tristynferreiro/perchscale/Housing/Controller_housing/Push_Button/Tach button.png

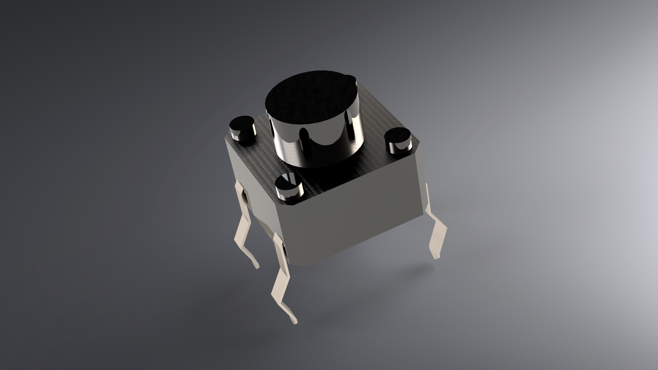
Housing/Controller_housing/Push_Button/Tach button.png
