tristynferreiro/perchscale/README.md

# The Hornbill Sensor Project
Project still in progress
