tristynferreiro/perchscale/Housing/Controller_housing/DM_OLED/1.inch OLED Display Overview.jpg

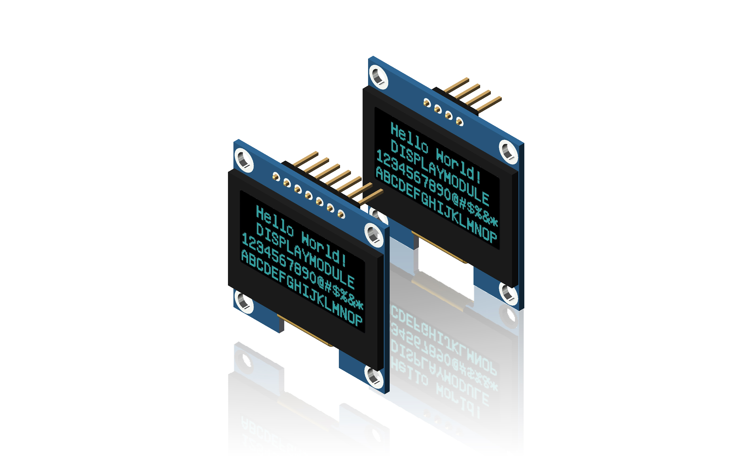
Housing/Controller_housing/DM_OLED/1.inch OLED Display Overview.jpg
