tristynferreiro/perchscale/Housing/Controller_housing/DM_OLED/AZ-Delivery.OLED13.IIC.Blue.jpg

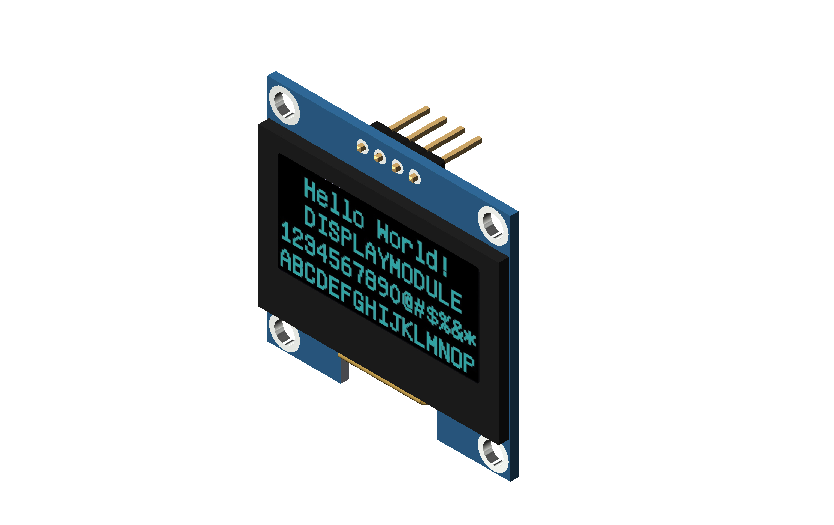
Housing/Controller_housing/DM_OLED/AZ-Delivery.OLED13.IIC.Blue.jpg
