tristynferreiro/perchscale/Housing/Controller_housing/Keystone_1042_Battery_Holder/keystone-PN1042 mechanical.JPG

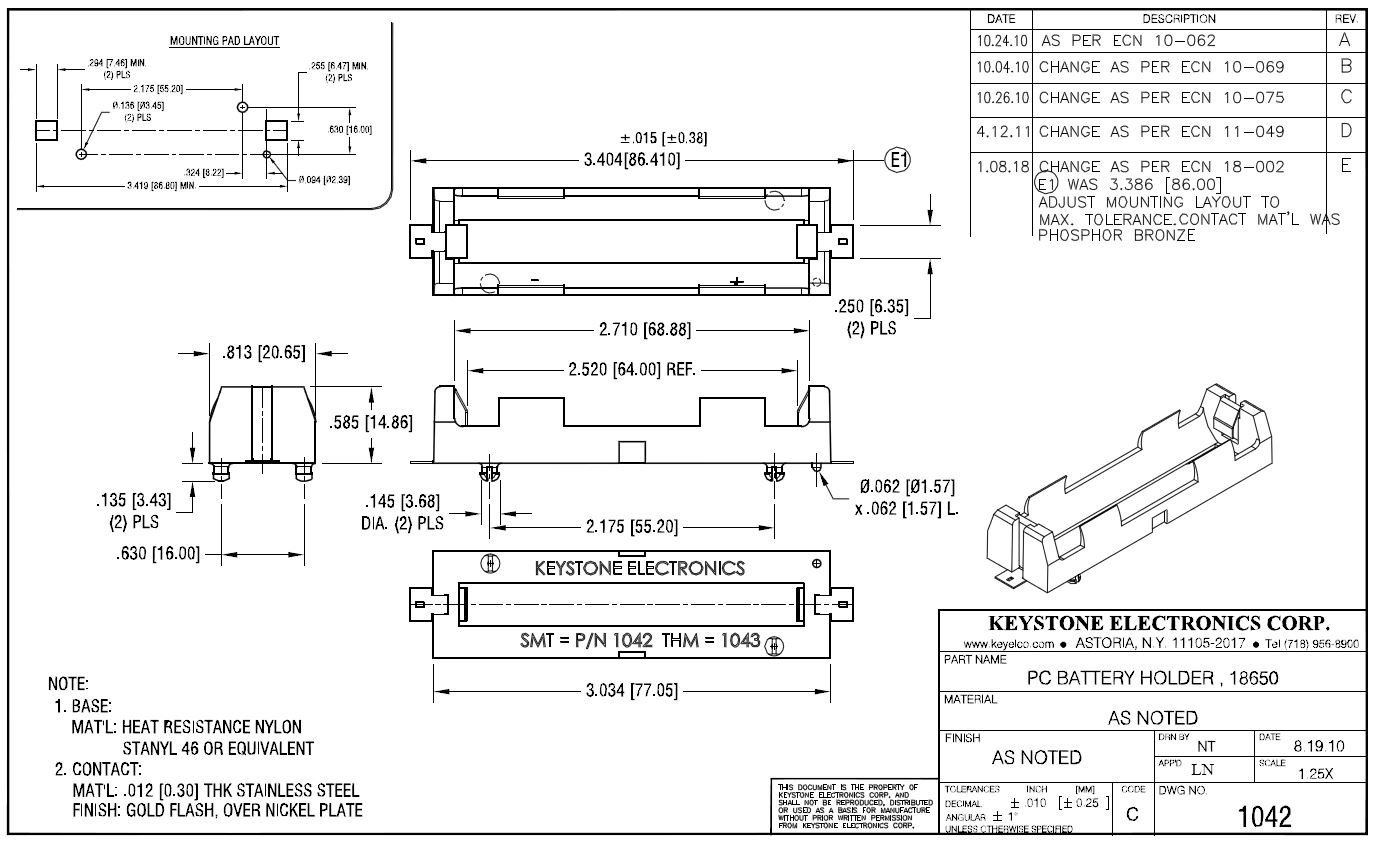
Housing/Controller_housing/Keystone_1042_Battery_Holder/keystone-PN1042 mechanical.JPG
