tristynferreiro/perchscale/Housing/Controller_housing/Keystone_1042_Battery_Holder/Keystone-PN1042 specification.JPG

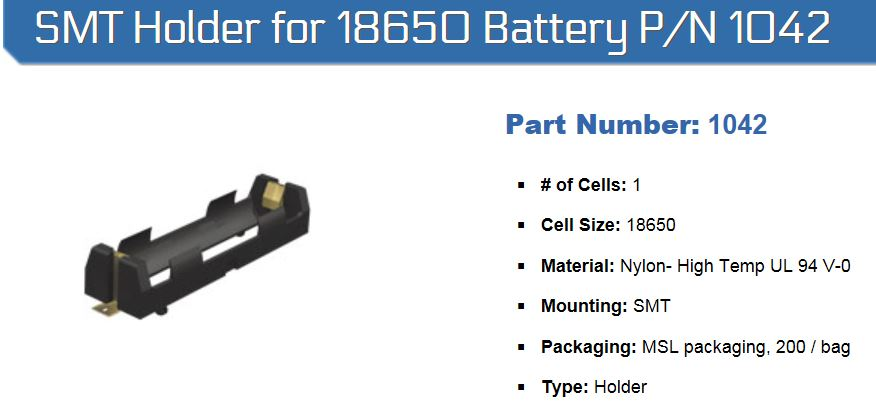
Housing/Controller_housing/Keystone_1042_Battery_Holder/Keystone-PN1042 specification.JPG
