tristynferreiro/perchscale/Housing/Controller_housing/DM_OLED/AZ-Delivery - OLED13 IIC.stp

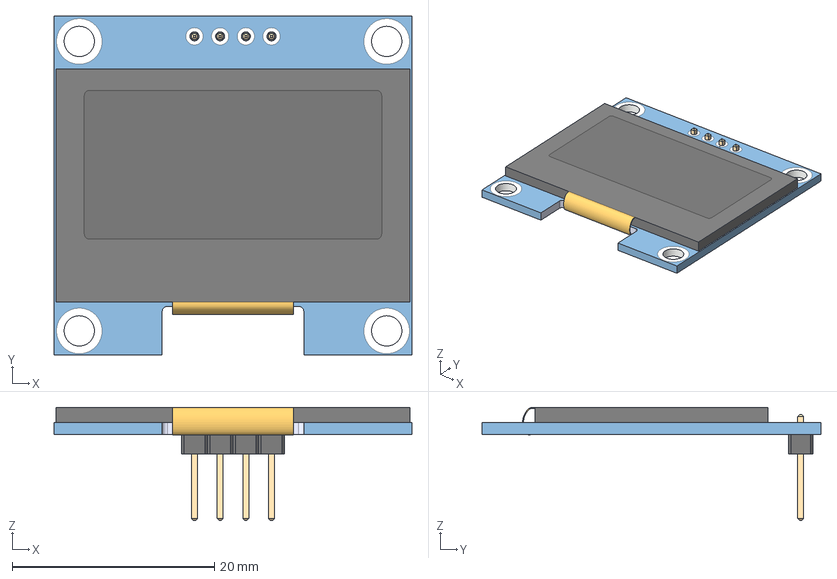
[picture p8: CAD file, 2024-08-07]
Housing/Controller_housing/DM_OLED/AZ-Delivery - OLED13 IIC.stp
35.4 x 33.5 x 11.2 mm
