tristynferreiro/perchscale/Housing/Controller_housing/Keystone_1042_Battery_Holder/keystone-PN1042.STEP

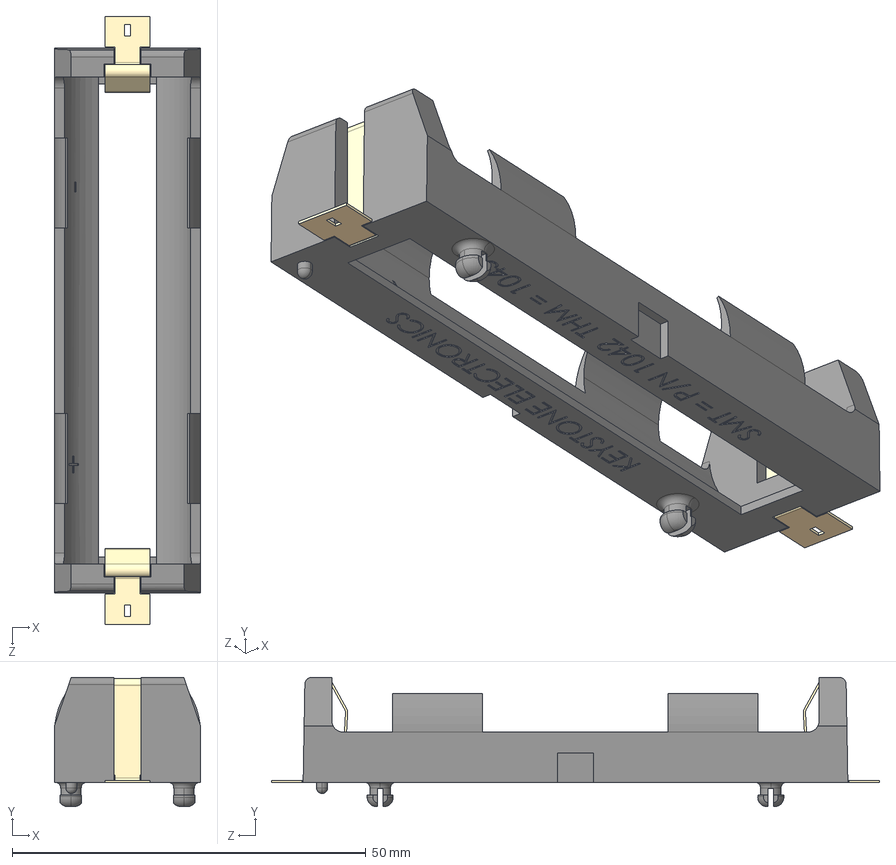
[picture p9: CAD file, 2024-08-07]
Housing/Controller_housing/Keystone_1042_Battery_Holder/keystone-PN1042.STEP
20.7 x 18.3 x 86.0 mm
