tristynferreiro/perchscale/Housing/Controller_housing/Push_Button/6x6 5mm Tach Buton (4 arm).STEP

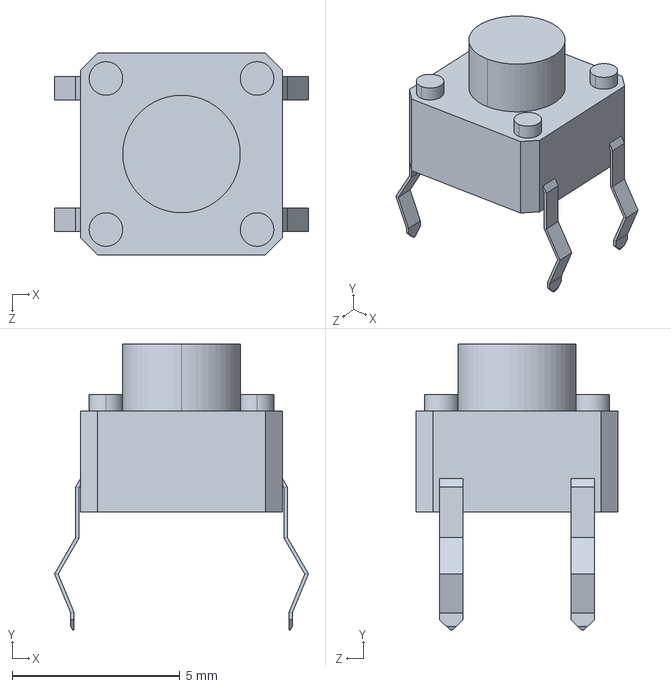
[picture p10: CAD file, 2024-08-07]
Housing/Controller_housing/Push_Button/6x6 5mm Tach Buton (4 arm).STEP
7.57 x 8.52 x 6.01 mm
