tristynferreiro/perchscale/Housing/perchdesign/perchdesign_tbar_v3.step

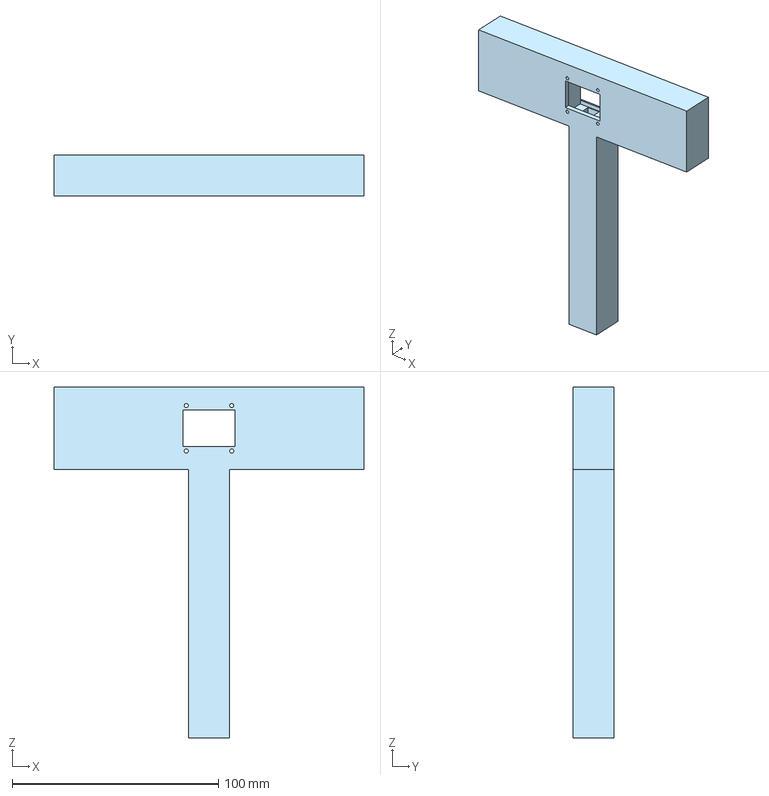
[picture p11: CAD file, 2024-06-24]
Housing/perchdesign/perchdesign_tbar_v3.step
150.0 x 20.0 x 170.0 mm
