tristynferreiro/perchscale/PCB/PS_motherboard/Additional Libraries/74LVC125APW_118/74LVC125APW_118.step

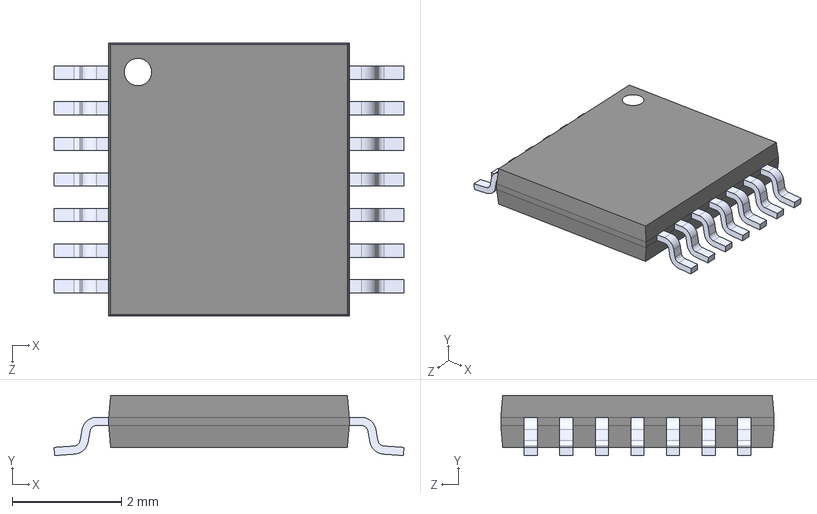
[picture p12: CAD file, 2024-03-22]
PCB/PS_motherboard/Additional Libraries/74LVC125APW_118/74LVC125APW_118.step
6.40 x 1.10 x 5.00 mm
