tristynferreiro/perchscale/PCB/PS_motherboard/Additional Libraries/ADC108S022CIMTX_NOPB/ADC108S022CIMTX_NOPB.step

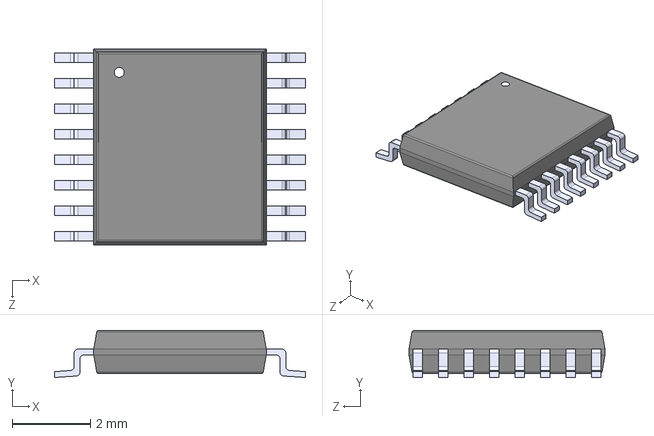
[picture p13: CAD file, 2024-03-22]
PCB/PS_motherboard/Additional Libraries/ADC108S022CIMTX_NOPB/ADC108S022CIMTX_NOPB.step
6.40 x 1.20 x 5.00 mm
