tristynferreiro/perchscale/PCB/PS_motherboard/Additional Libraries/TMP235A2DCKR/TMP235A2DCKR.step

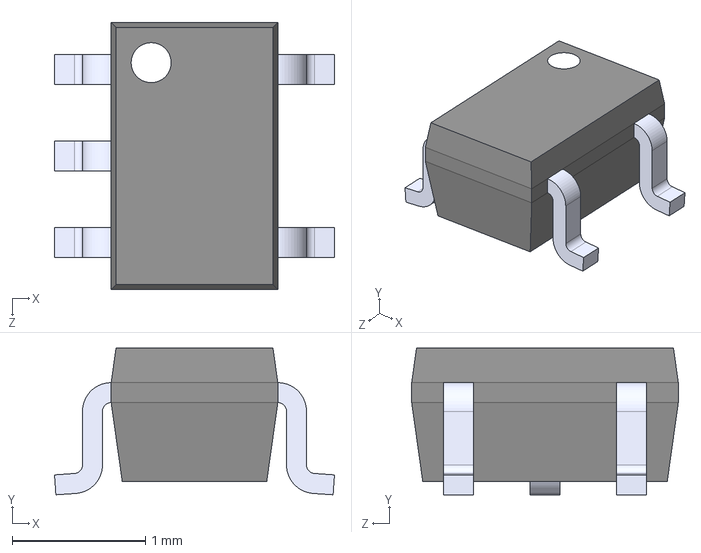
[picture p14: CAD file, 2024-03-22]
PCB/PS_motherboard/Additional Libraries/TMP235A2DCKR/TMP235A2DCKR.step
2.10 x 1.10 x 2.00 mm
