tristynferreiro/perchscale/Housing/Perch Box V7.stl

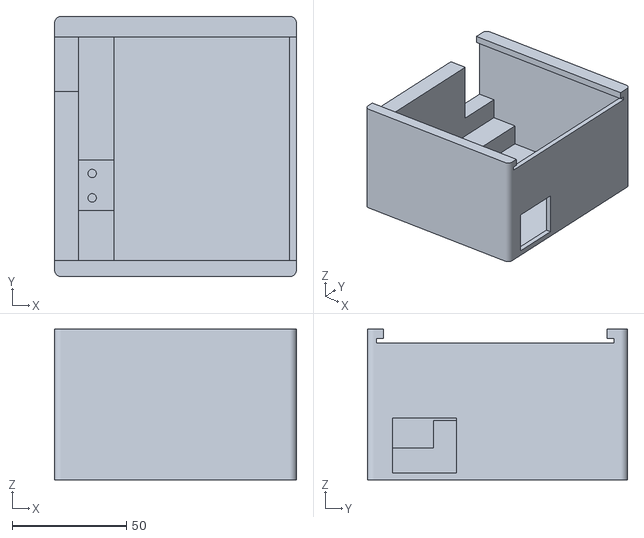
[picture p15: CAD file, 2024-02-02]
Housing/Perch Box V7.stl
106.0 x 114.0 x 66.0
