tristynferreiro/perchscale/Housing/perchdesign/perchdesign_nbarhousinglid_v1.step

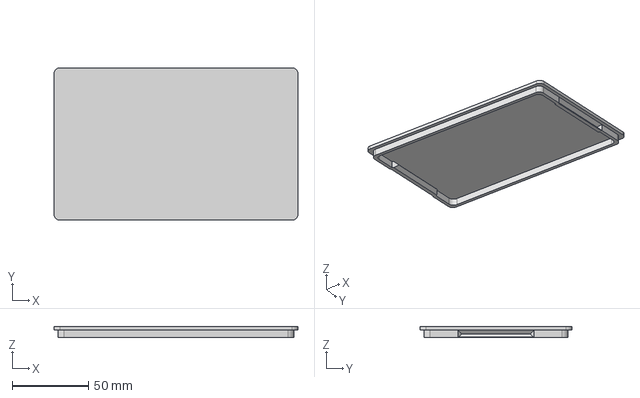
[picture p16: CAD file, 2024-06-24]
Housing/perchdesign/perchdesign_nbarhousinglid_v1.step
160.0 x 100.0 x 7.50 mm
