tristynferreiro/perchscale/Housing/perchdesign/perchdesign_tbarslider_v1.step

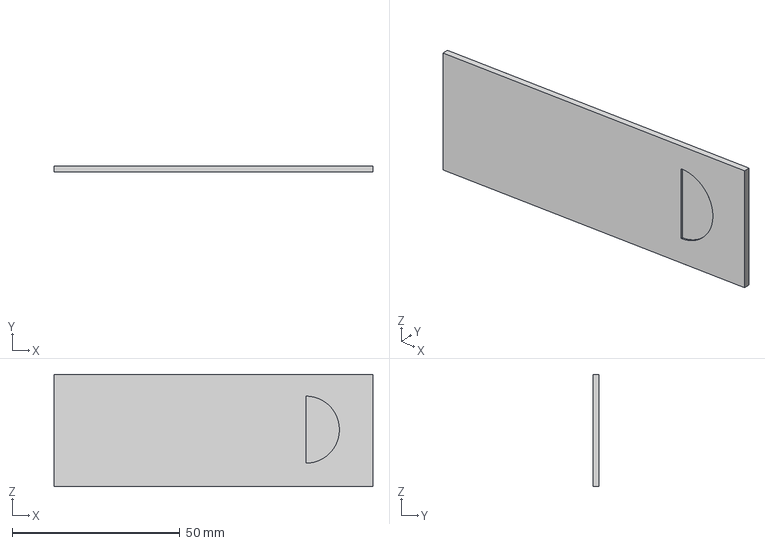
[picture p17: CAD file, 2024-06-24]
Housing/perchdesign/perchdesign_tbarslider_v1.step
95.0 x 1.75 x 33.5 mm
