tristynferreiro/perchscale/Housing/perchdesign/perchdesign_nbarhousingbox_v1.step

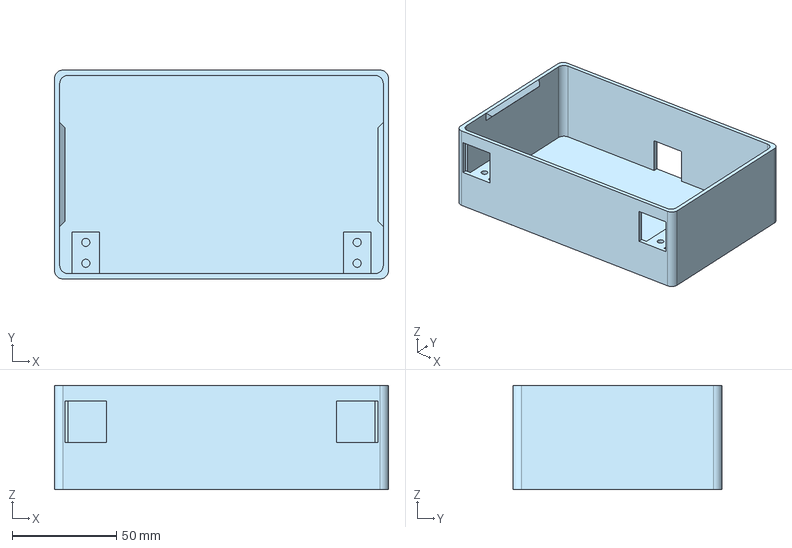
[picture p18: CAD file, 2024-06-24]
Housing/perchdesign/perchdesign_nbarhousingbox_v1.step
160.0 x 100.0 x 50.0 mm
