tristynferreiro/perchscale/Housing/perchdesign/perchdesign_tbarhousinglid_v3.step

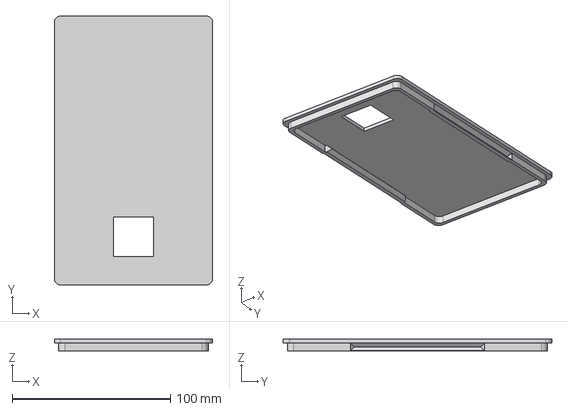
[picture p19: CAD file, 2024-06-24]
Housing/perchdesign/perchdesign_tbarhousinglid_v3.step
100.0 x 170.0 x 7.50 mm
