tristynferreiro/perchscale/Housing/perchdesign/perchdesign_tbarhousingbox_v3.step

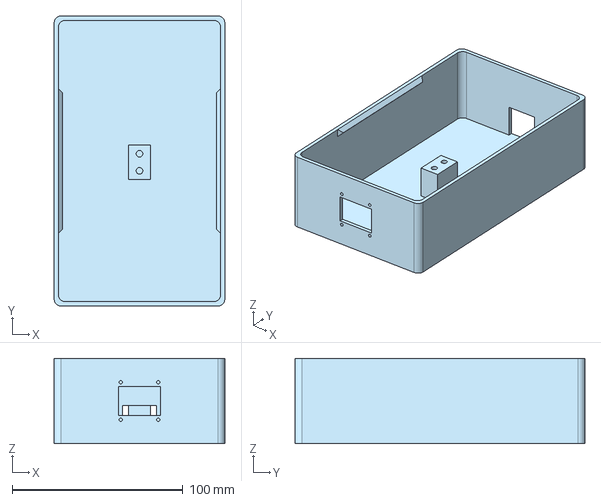
[picture p20: CAD file, 2024-06-24]
Housing/perchdesign/perchdesign_tbarhousingbox_v3.step
100.0 x 170.0 x 50.0 mm
