tristynferreiro/perchscale/Housing/perchdesign/housing - Box.stl

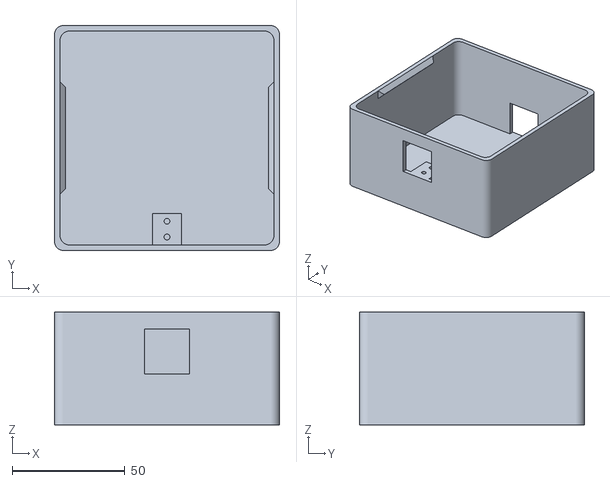
[picture p21: CAD file, 2024-04-19]
Housing/perchdesign/housing - Box.stl
100.0 x 100.0 x 50.0
