tristynferreiro/perchscale/Housing/Scale Base.stl

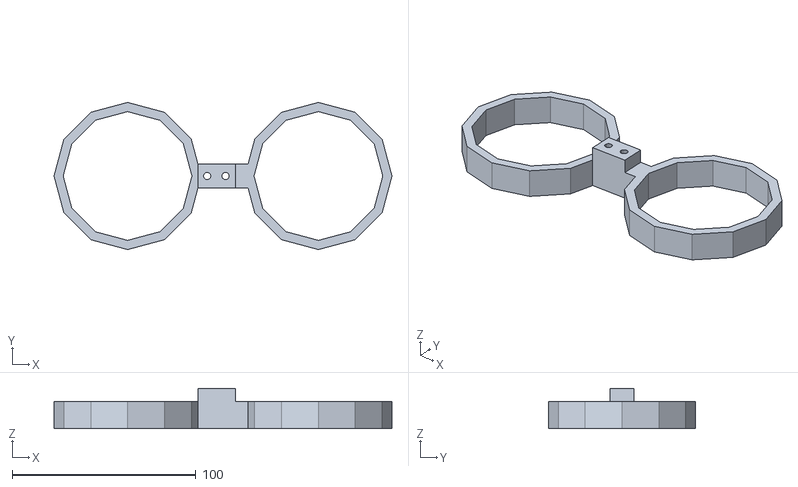
[picture p22: CAD file, 2023-05-17]
Housing/Scale Base.stl
183.8 x 80.0 x 22.0
