tristynferreiro/perchscale/Housing/Perch.stl

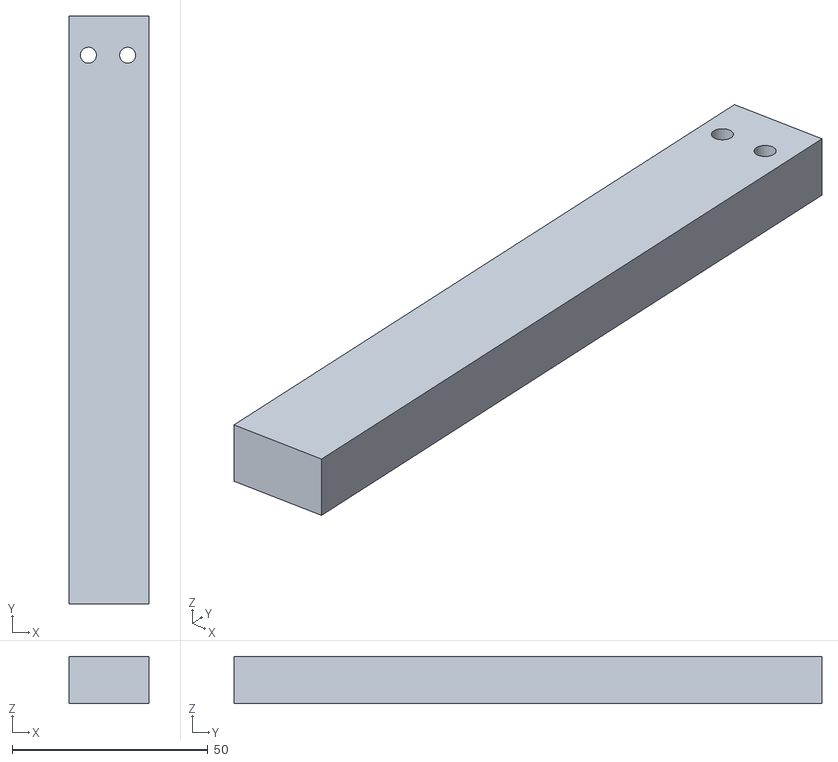
[picture p23: CAD file, 2023-05-17]
Housing/Perch.stl
20.5 x 150.0 x 12.0
