tristynferreiro/perchscale/Housing/perchdesign/perchdesign_nbar_v1.step

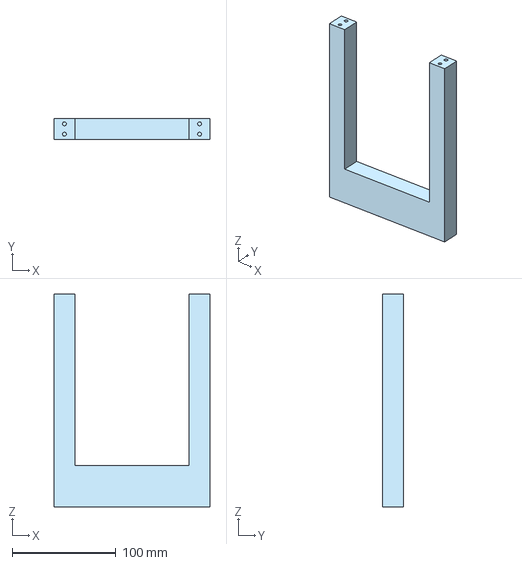
[picture p24: CAD file, 2024-04-19]
Housing/perchdesign/perchdesign_nbar_v1.step
150.0 x 20.0 x 205.0 mm
