tristynferreiro/perchscale/Housing/perchdesign/perchdesign_nbar_v1_10cm_height.step

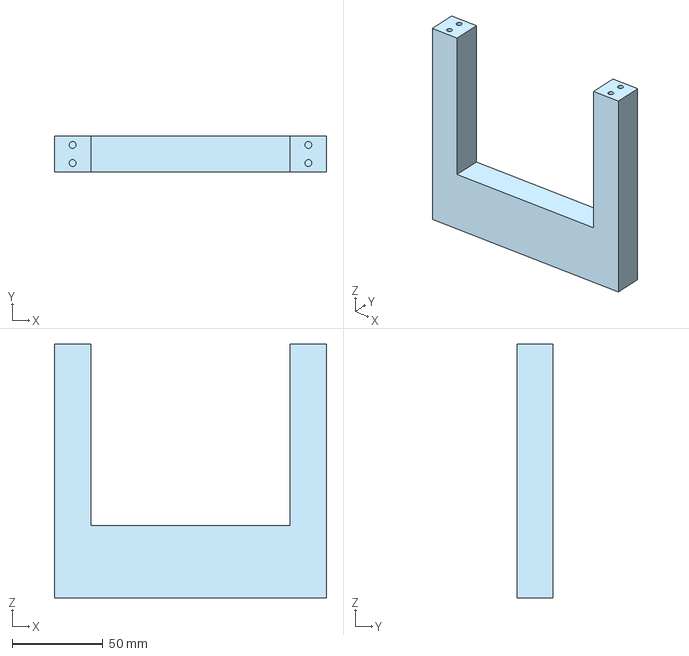
[picture p25: CAD file, 2024-04-19]
Housing/perchdesign/perchdesign_nbar_v1_10cm_height.step
150.0 x 20.0 x 140.0 mm
