tristynferreiro/perchscale/Housing/perchdesign/perchdesign_tbar_v1.stl

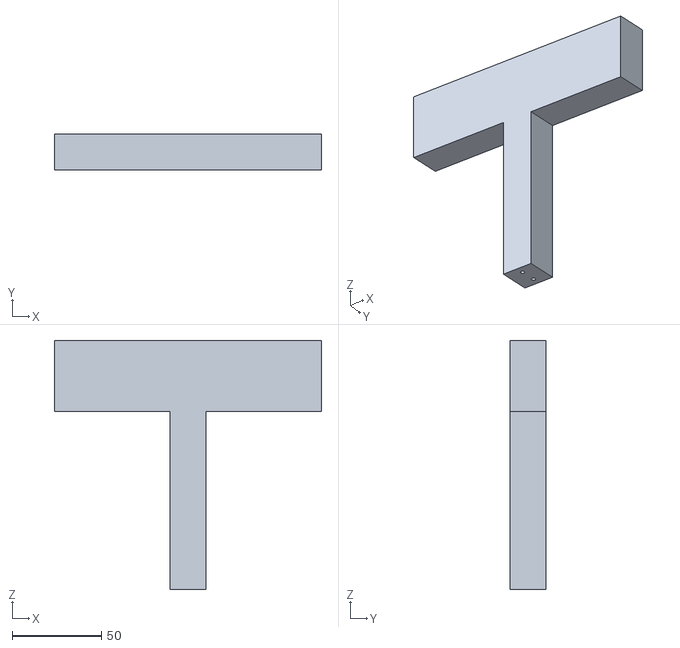
[picture p26: CAD file, 2024-04-12]
Housing/perchdesign/perchdesign_tbar_v1.stl
150.0 x 20.0 x 140.0
