tristynferreiro/perchscale/(list of files, cad)

Other CAD files:
Housing/Controller_housing/Push_Button/6x6 5mm Tach Buton (4 arm).SLDPRT
Housing/Perch Box V1.stl
Housing/Perch Box V2.stl
Housing/Perch Box V3.stl
Housing/Perch Box V4.stl
Housing/Perch Box V5.stl
Housing/Perch Box V6.stl
Housing/perchdesign/perchdesign_tbar_v2.step
Housing/perchdesign/perchdesign_tbarhousingbox_v1.step
Housing/perchdesign/perchdesign_tbarhousinglid_v1.step
Housing/testprints_screw_sizing.step
