tristynferreiro/perchscale/EEE4113F/Kalman_Filter/test_scale.txt

303.99
303.98
303.97
303.95
303.94
303.93
303.93
303.92
303.91
303.90
303.88
303.88
303.87
303.86
303.85
303.84
303.83
303.83
303.84
303.84
303.84
303.84
303.85
303.85
303.85
303.85
303.84
303.85
303.85
303.85
303.85
303.86
303.86
303.87
303.87
303.87
303.87
303.87
303.87
303.87
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

done

91.30
110.28
129.21
146.89
160.96
171.62
181.11
190.68
201.82
216.06
230.47
243.01
251.28
255.12
252.91
248.94
246.73
244.43
236.45
227.18
220.06
217.34
220.90
229.08
238.30
246.62
253.05
255.29
253.83
249.57
244.50
244.21
249.96
256.27
255.92
250.22
248.32
249.97
253.42
256.85
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

done

86.57
105.56
124.53
143.51
162.50
181.48
200.46
219.45
238.39
255.89
271.42
285.92
296.56
301.77
303.59
303.91
303.92
303.63
303.63
303.62
303.62
303.61
303.60
303.59
303.58
303.57
303.57
303.56
303.56
303.56
303.55
303.55
303.55
303.55
303.55
303.55
303.54
303.54
303.55
303.55
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

82.46
101.38
120.36
139.34
158.34
177.46
196.47
215.45
234.43
252.87
270.40
287.09
298.49
304.03
306.00
306.08
305.84
306.73
308.43
314.22
316.70
316.81
316.82
316.71
316.78
317.41
317.95
318.00
318.00
317.36
316.02
315.37
315.06
315.05
314.87
313.23
307.60
305.15
304.58
304.92
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

done

85.11
104.07
123.04
142.02
160.99
179.96
198.93
217.89
236.86
255.61
272.58
287.06
295.55
300.12
302.62
302.62
302.24
301.81
301.86
301.89
301.91
301.94
302.18
301.83
301.21
301.23
301.27
301.09
299.87
298.71
298.98
299.23
299.38
300.30
301.41
301.90
302.10
302.34
302.01
301.98
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

done

90.07
109.20
128.27
147.27
166.26
185.24
204.24
223.23
242.22
261.08
278.36
293.18
301.80
304.23
304.32
304.32
304.21
304.07
304.00
303.91
303.91
303.90
303.90
303.90
303.90
304.01
305.15
305.62
305.61
305.59
305.59
305.58
305.41
304.58
301.29
299.64
298.93
297.49
295.71
295.39
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

done

85.20
104.22
123.24
142.26
161.27
180.30
199.32
218.58
237.83
256.61
274.26
288.81
299.94
304.49
304.76
304.83
304.37
303.40
303.11
303.12
303.12
303.12
303.12
303.11
303.13
303.13
303.26
303.54
303.50
302.90
301.58
300.80
300.76
300.92
301.69
303.02
303.29
303.46
303.68
303.40
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

84.55
103.54
122.51
141.50
160.48
179.47
198.46
217.44
236.42
255.38
272.91
287.32
298.13
302.45
303.85
304.07
304.07
304.07
304.06
304.05
304.04
304.04
304.03
304.02
304.02
304.01
304.00
304.00
303.99
303.99
303.98
303.98
303.97
303.97
303.97
303.97
303.97
303.97
303.97
303.97
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

done

81.34
98.76
116.74
135.07
153.90
172.88
191.89
210.62
228.48
245.57
260.98
273.62
282.83
289.25
294.17
297.90
300.59
302.19
303.21
303.90
304.07
304.22
304.25
304.25
304.25
304.31
304.32
304.32
304.33
304.33
304.34
304.34
304.34
304.34
304.35
304.35
304.36
304.37
304.38
304.39
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

done
