tristynferreiro/perchscale/EEE4113F/Kalman_Filter/Kalman Filters.pdf

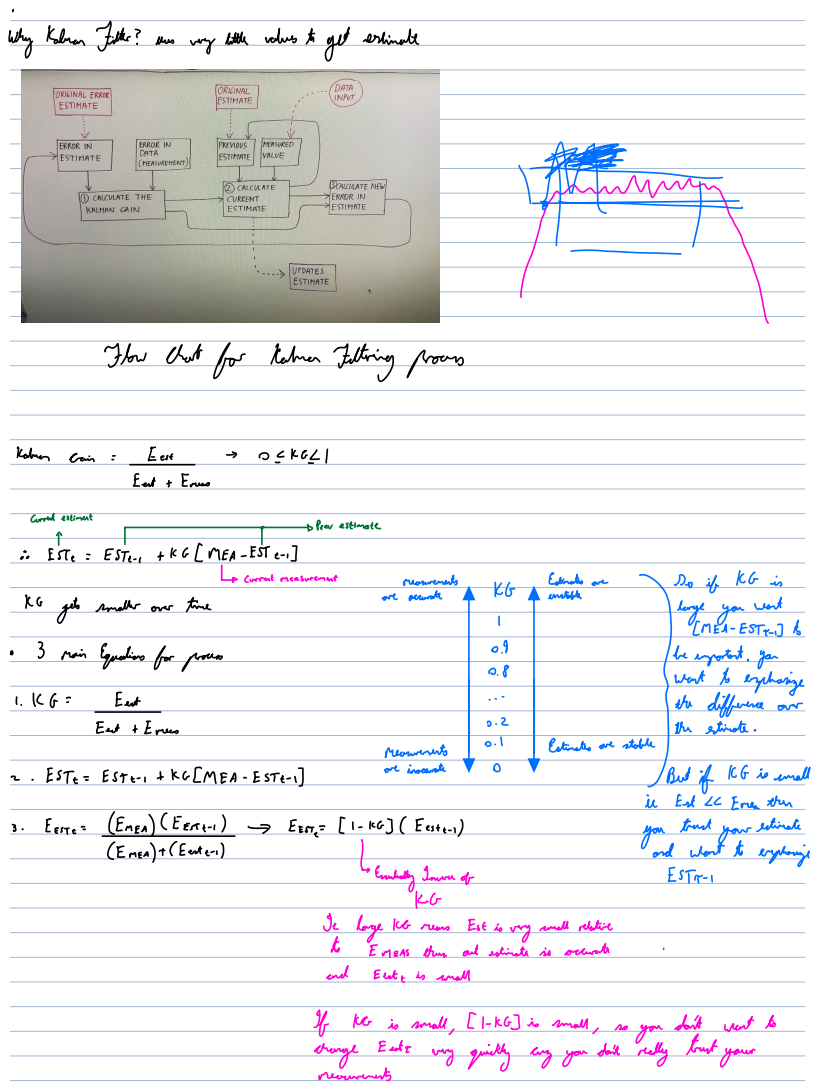
[picture p27: page 1]
Kahn can; Eest; Eet Ems; Of key; Eestinut; Este e Este; ka menEge; otherestimate; areaccurate; Estateswe; rat; moments; KG www; largeyou; went; MEAESTDA; 3 main Equationsforpoems; beimpotent you 0.8; went A emphasize; the difference our 1 KG EETtEven; nun; anyway; guy; Este Este t KCMEA EsteD; Minocaat; Butif KGissmall; ie EstLCEmeathen; 3 EEste; Emea EEstt 1; you; trustyour estimate; and wentA euphemize; EmuliallyImanof; ESTTI; don't wantto

WhyKalmanFitter um verylittle values tgetestimate

Flow thatfor KahnFittingpoor

Ko gets smaller on time

Je lageKermeans Estisverysmallrelative
A Emeasthus outestimate is accurate
and Eesti is small

If 100 is small Ci ko is small soyou
change Ente very quietly ayyou
your recruits

don't really trust
