tristynferreiro/perchscale/PCB/PS_motherboard/PS_motherboard.kicad_pcb

## KiCad design PCB/PS_motherboard/PS_motherboard.kicad_pcb (2024-03-22)

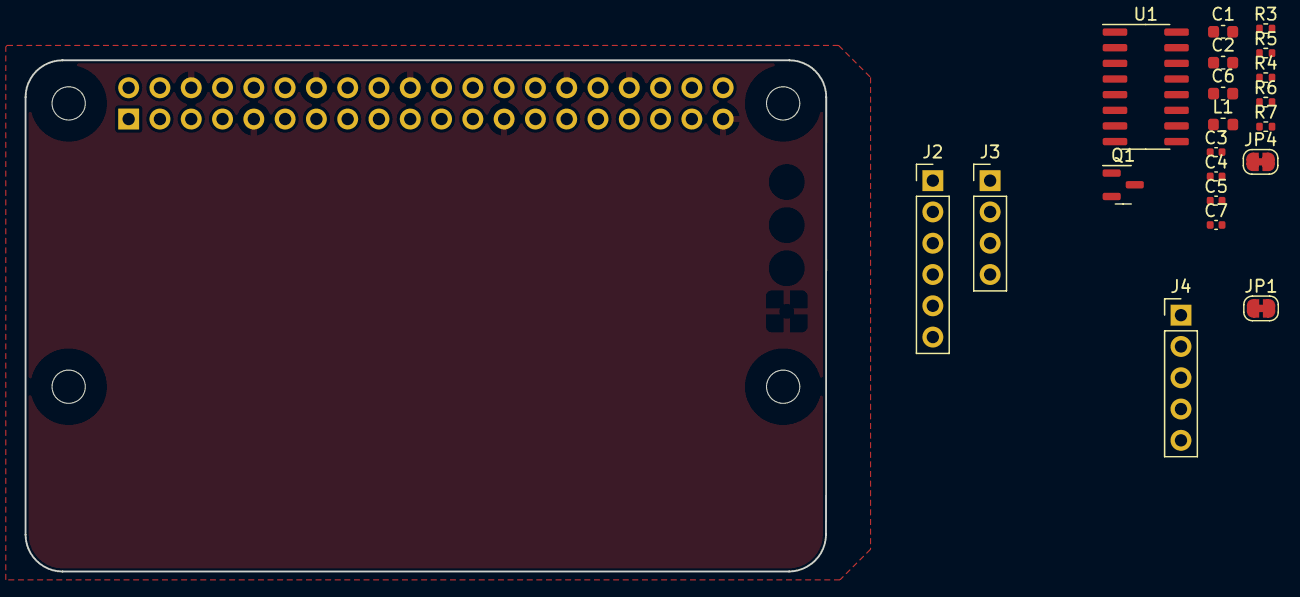
[picture p28: board PS_motherboard.kicad_pcb from above]

Board: 2 copper layers, 65.0 x 41.5 mm, 25 parts (1 on the bottom side), 19 nets, no tracks yet.

Parts:
C1: 100n; C_0603_1608Metric
C2, C6: 10u; C_0603_1608Metric
C3, C4, C5, C7: 100n; C_0402_1005Metric
H1, H2, H3, H4: MountingHole; MountingHole_2.7mm_M2.5_uHAT_RPi
J2: Conn_01x06_Socket; PinHeader_1x06_P2.54mm_Vertical
J3: Conn_01x04_Socket; PinHeader_1x04_P2.54mm_Vertical
J4: Conn_01x05_Pin; PinHeader_1x05_P2.54mm_Vertical
J5: GPIO_CONNECTOR; PinSocket_2x20_P2.54mm_Vertical_Centered_Anchor
JP1, JP4: RATE; SolderJumper-2_P1.3mm_Bridged_RoundedPad1.0x1.5mm
L1: 3.3uH; L_0603_1608Metric
Q1: S8550; SOT-23
R3, R4: 100R; R_0402_1005Metric
R5: 12k; R_0402_1005Metric
R6: 27k; R_0402_1005Metric
R7: 10k; R_0402_1005Metric
U1: HX711; SOP-16_3.9x9.9mm_P1.27mm

Connections:
+3.3V: C5.1, J4.1, J5.1, J5.17, U1.16 (DVDD)
+5V: C6.1, C7.1, J3.1, J5.2, J5.4, Q1.3 (C), R7.2, U1.1 (VSUP)
/EXC+: C1.1, C2.1, J2.1, L1.1
/GPIO2_SDA1: J4.2, J5.3
/GPIO3_SCL1: J4.3, J5.5
/GPIO5: J3.3, J5.29, U1.12 (DOUT)
/GPIO6: J3.4, J5.31, U1.11 (PD_SCK)
/INA+: J2.4, R3.1
/INA-: J2.3, R4.1
/INB+: J2.6, U1.9 (INB-)
/INB-: J2.5, U1.10 (INB+)
GND: C1.2, C2.2, C4.2, C5.2, C6.2, C7.2, J2.2, J3.2, J4.5, J5.6, J5.9, J5.14, J5.20, J5.25, J5.30, J5.34, J5.39, JP1.1 (A), JP4.1 (A), R5.1, U1.5 (AGND), U1.14 (XI)
unnamed: JP1.2 (B), R7.1, U1.15 (RATE)
unnamed: Q1.1 (B), U1.2 (BASE)
unnamed: L1.2, Q1.2 (E), R6.1, U1.3 (AVDD)
unnamed: C3.1, R3.2, U1.8 (INA+)
unnamed: C3.2, R4.2, U1.7 (INA-)
unnamed: C4.1, U1.6 (VBG)
unnamed: R5.2, R6.2, U1.4 (VFB)
