tristynferreiro/perchscale/Software/ESP32/scale/scale_readings_oleddisplay_serialprint_working/scale_readings_oleddisplay_serialprint_working.ino

/*
* SCRIPT DESCRIPTION
*
* Working: 5/04/2024
*
* Pin connections:
*   SCL of OLED -> SCL (PIN 22) of ESP32
*   SDA of OLED -> SDA (PIN 21) of ESP32
*   GND of OLED -> GND of ESP32
*   Vcc of OLED -> 3.3V of ESP32
*
*   SCL of HX -> SCL (PIN 33) of ESP32
*   SDA of HX -> SDA (PIN 32) of ESP32
*   GND of HX -> GND of ESP32
*   Vcc of HX -> 5V of ESP32
*/

//------------------INCLUDES------------------------
#include <HX711_ADC.h>
#if defined(ESP8266)|| defined(ESP32) || defined(AVR)
#include <EEPROM.h>
// OLED
#include <Wire.h>
#include <Adafruit_GFX.h>
#include <Adafruit_SSD1306.h>
// String
#include <string>
#endif

//--------------------DEFINES-------------------------
#define eigthseconds (millis()/125) // Taring delay
#define SCREEN_WIDTH 128 // OLED display width, in pixels
#define SCREEN_HEIGHT 64 // OLED display height, in pixels

//--------------------GLOBAL VARIABLES-----------------
// pins:
const int HX711_dout = 32; // D32 mcu > HX711 dout pin 
const int HX711_sck = 33; // D33 mcu > HX711 sck pin

HX711_ADC LoadCell(HX711_dout, HX711_sck); // instantiate an HX711 object

Adafruit_SSD1306 display(SCREEN_WIDTH, SCREEN_HEIGHT, &Wire, -1); // Instantiate an SSD1306 display connected to I2C

// EEPROM address
const int calVal_eepromAdress = 0;

int num_readings = 0; // scale readings counter
//------------------------------------------------------

void setup() {
  // SERIAL SETUP
  Serial.begin(9600); // Initialise baud rate with PC
  
  // LOADCELL SETUP
  LoadCell.begin();
  // LoadCell.setReverseOutput(); //uncomment to turn a negative output value to positive
  unsigned long stabilizingtime = 2000; // preciscion right after power-up can be improved by adding a few seconds of stabilizing time
  boolean _tare = true; //set this to false if you don't want tare to be performed in the next step
  LoadCell.start(stabilizingtime, _tare);

  if (LoadCell.getTareTimeoutFlag() || LoadCell.getSignalTimeoutFlag()) {
    Serial.println("Timeout, check MCU>HX711 wiring and pin designations");
    while (1);
  }
  // else {
  //   LoadCell.setCalFactor(1.0); // user set calibration value (float), initial value 1.0 may be used for this sketch
  //   Serial.println("Startup is complete");
  // }
    if(!display.begin(SSD1306_SWITCHCAPVCC, 0x3C)) { // Address 0x3D for 128x64
    Serial.println(F("SSD1306 allocation failed"));
    for(;;);
  }
  delay(2000);
  display.clearDisplay();

  Serial.println("Startup is complete");

  // Output that startup is complete on display
  writeToDisplayCentre(2.5, WHITE, "Startup complete");

  while (!LoadCell.update());
  calibrate(); //start calibration procedure
}

void loop() {

  static boolean newDataReady = 0;

  // check for new data/start next conversion:
  if (LoadCell.update()) newDataReady = true;

  if (newDataReady) {
      float reading = LoadCell.getData();
      if(reading<1 & eigthseconds%80 == 0){ //Condition to set new tare every 1000 milliseconds
        boolean _resume = false;
        boolean _tarewait = true;
        while (_resume == false) {
          LoadCell.update();
          if(_tarewait){              
            LoadCell.tareNoDelay();
            _tarewait = false;
          }
          if (LoadCell.getTareStatus() == true) {
            
            writeToDisplayCentre(2.5, WHITE, "Tare done");
            // writeToDisplay(2.5, WHITE, 0, 10, "Tare done");

            Serial.println("Next Tare Complete");
            _resume = true;
            // delay(2000);
          }
        }
      }
      else if (reading>1){ //If a bird or heavy object is detected on the scale
          String reading_msg = String(reading) + "g";
          writeToDisplayCentre(3, WHITE, reading_msg.c_str());
          // writeToDisplay(3, WHITE, 0, 4, reading_msg.c_str());
          Serial.println(String(num_readings) + "," + String(reading));
          newDataReady = 0;
          num_readings++;
      }
    
  }

  // receive command from serial terminal
  if (Serial.available() > 0) {
    char inByte = Serial.read();
    if (inByte == 't') LoadCell.tareNoDelay(); //tare
    else if (inByte == 'r') calibrate(); //calibrate
    else if (inByte == 'c') changeSavedCalFactor(); //edit calibration value manually
  }

  // check if last tare operation is complete
  if (LoadCell.getTareStatus() == true) {
    writeToDisplayCentre(2.5, WHITE, "Tare done");
    // writeToDisplay(2.5, WHITE, 0, 10, "Tare done");

    Serial.println("Tare complete");
  }

}

//------------------HELPER FUNCTIONS------------------------
void writeToDisplay(int textSize, char textColour, int cursorX, int cursorY, const char* msgToPrint) {
  display.clearDisplay();
  display.setTextSize(textSize);
  display.setTextColor(textColour);
  display.setCursor(cursorX, cursorY);
  display.print(msgToPrint);
  display.display(); 
}

void writeToDisplayCentre(int textSize, char textColour, const char* text) {
  int16_t x1;
  int16_t y1;
  uint16_t width;
  uint16_t height;

  display.getTextBounds(text, 0, 0, &x1, &y1, &width, &height);

  // display on horizontal and vertical center
  display.clearDisplay(); // clear display
  display.setTextSize(textSize);
  display.setTextColor(textColour);
  display.setCursor((SCREEN_WIDTH - width) / 2, (SCREEN_HEIGHT - height) / 2);
  display.println(text); // text to display
  display.display();
}


void calibrate() {

  // writeToDisplay(2, WHITE, 0, 10, "Calibrating...");
  writeToDisplayCentre(2, WHITE, "Calibrating...");

  Serial.println("***");
  Serial.println("Start calibration:");
  Serial.println("Place the load cell an a level stable surface.");
  Serial.println("Remove any load applied to the load cell.");
  Serial.println("Send 't' from serial monitor to set the tare offset.");

  boolean _resume = false;
  while (_resume == false) {
    LoadCell.update();
    if (Serial.available() > 0) {
      if (Serial.available() > 0) {
        char inByte = Serial.read();
        if (inByte == 't') LoadCell.tareNoDelay();
      }
    }
    if (LoadCell.getTareStatus() == true) {
      Serial.println("Tare complete");
      _resume = true;
    }
  }

  Serial.println("Now, place your known mass on the loadcell.");
  Serial.println("Then send the weight of this mass (i.e. 100.0) from serial monitor.");

  float known_mass = 0;
  _resume = false;
  while (_resume == false) {
    LoadCell.update();
    if (Serial.available() > 0) {
      known_mass = Serial.parseFloat();
      if (known_mass != 0) {
        Serial.print("Known mass is: ");
        Serial.println(known_mass);
        _resume = true;
      }
    }
  }

  LoadCell.refreshDataSet(); //refresh the dataset to be sure that the known mass is measured correct
  float newCalibrationValue = LoadCell.getNewCalibration(known_mass); //get the new calibration value

  Serial.print("New calibration value has been set to: ");
  Serial.print(newCalibrationValue);
  Serial.println(", use this as calibration value (calFactor) in your project sketch.");
  Serial.print("Save this value to EEPROM adress ");
  Serial.print(calVal_eepromAdress);
  Serial.println("? y/n");

  _resume = false;
  while (_resume == false) {
    if (Serial.available() > 0) {
      char inByte = Serial.read();
      if (inByte == 'y') {
#if defined(ESP8266)|| defined(ESP32)
        EEPROM.begin(512);
#endif
        EEPROM.put(calVal_eepromAdress, newCalibrationValue);
#if defined(ESP8266)|| defined(ESP32)
        EEPROM.commit();
#endif
        EEPROM.get(calVal_eepromAdress, newCalibrationValue);
        Serial.print("Value ");
        Serial.print(newCalibrationValue);
        Serial.print(" saved to EEPROM address: ");
        Serial.println(calVal_eepromAdress);
        _resume = true;

      }
      else if (inByte == 'n') {
        Serial.println("Value not saved to EEPROM");
        _resume = true;
      }
    }
  }

  // writeToDisplay(2, WHITE, 0, 10, "Calibration complete!");
  writeToDisplayCentre(2, WHITE, "Calibration complete!");

  Serial.println("End calibration");
  Serial.println("***");
  Serial.println("To re-calibrate, send 'r' from serial monitor.");
  Serial.println("For manual edit of the calibration value, send 'c' from serial monitor.");
  Serial.println("***");

  delay(2000);
}

void changeSavedCalFactor() {
  float oldCalibrationValue = LoadCell.getCalFactor();
  boolean _resume = false;
  Serial.println("***");
  Serial.print("Current value is: ");
  Serial.println(oldCalibrationValue);
  Serial.println("Now, send the new value from serial monitor, i.e. 696.0");
  float newCalibrationValue;
  while (_resume == false) {
    if (Serial.available() > 0) {
      newCalibrationValue = Serial.parseFloat();
      if (newCalibrationValue != 0) {
        Serial.print("New calibration value is: ");
        Serial.println(newCalibrationValue);
        LoadCell.setCalFactor(newCalibrationValue);
        _resume = true;
      }
    }
  }
  _resume = false;
  Serial.print("Save this value to EEPROM adress ");
  Serial.print(calVal_eepromAdress);
  Serial.println("? y/n");
  while (_resume == false) {
    if (Serial.available() > 0) {
      char inByte = Serial.read();
      if (inByte == 'y') {
#if defined(ESP8266)|| defined(ESP32)
        EEPROM.begin(512);
#endif
        EEPROM.put(calVal_eepromAdress, newCalibrationValue);
#if defined(ESP8266)|| defined(ESP32)
        EEPROM.commit();
#endif
        EEPROM.get(calVal_eepromAdress, newCalibrationValue);
        Serial.print("Value ");
        Serial.print(newCalibrationValue);
        Serial.print(" saved to EEPROM address: ");
        Serial.println(calVal_eepromAdress);
        _resume = true;
      }
      else if (inByte == 'n') {
        Serial.println("Value not saved to EEPROM");
        _resume = true;
      }
    }
  }
  Serial.println("End change calibration value");
  Serial.println("***");
}
