tristynferreiro/perchscale/EEE4113F/Software/EEE4113F_Code/Web_File_Download_v2/Network.h

// Adjust the following values to match your needs
// -----------------------------------------------
#define   servername "featherweb"     // Set your server's logical name here e.g. if myserver then address is http://myserver.local/
