tristynferreiro/perchscale/(commit log)

2023-04-15 Added TP4056 voltage regulator datasheet
2023-04-15 Scale Calibration Base Code
2023-04-15 Added HX711X Library to be imported into Arduino IDE to use the scale code
2023-04-15 Arduino test code
2023-04-15 Updated Calibration Code to work on ESP32
2023-04-15 Wireless Network: Working webserver test
2023-04-22 interim PCB design
    [hornbill_hat.kicad_pcb, hornbill_hat.kicad_sch]
2023-04-22 Added arduino files for scale
2023-04-27 Mishay's calibration code
2023-04-30 UART data sending test code
2023-04-30 Tristyn's UART Sauce
2023-04-30 Receive data oveer UART and write to SD card
2023-04-30 Updated UART sender code with scale stuff
2023-04-30 Sending Scale Data over UARTgit add .git add .
2023-05-13 Added UART scale testing project
2023-05-13 Updated Scale UART program
2023-05-17 The business/working scale code
    [Perch Box V2.stl, Perch Box V3.stl, Perch Box V4.stl, Perch Box V5.stl, Perch Box V6.stl, Scale Base.stl, Scale Stand.stl, perchScale.stl]
2023-05-18 powerpoint presentation
2024-02-02 Added the stl file for Perch Box V7
    [Perch Box V7.stl]
2024-02-07 Created the Calibration.py file
2024-02-07 Reorganised the github
    [Perch Box V1.stl, Perch Box V2.stl, Perch Box V3.stl, Perch Box V4.stl, Perch Box V5.stl, Perch Box V6.stl, Perch Box V7.stl, Perch.stl]
2024-02-07 Camera - simple script to capture still images and save them to files
2024-02-07 Camera - simple script to capture video and save to files
2024-03-22 Added Motherboard PCB files
    [74LVC125APW_118.step, ADC108S022CIMTX_NOPB.step, BOM-Pi HAT.csv, PS_motherboard.kicad_pcb, PS_motherboard.kicad_sch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]
2024-03-22 Updated LCSC part numbers and footprints for all parts EXCEPT PB and Screw Terminals (added comments why not)
    [PS_motherboard.kicad_sch, hx711.kicad_sch]
2024-03-25 Update footprints
    [PS_motherboard.kicad_sch, hx711.kicad_sch]
2024-03-29 ESP32: working scale code that writes to serial output
2024-04-12 RTC: added working interfacing script between Pi RTC and ESP32
2024-04-12 Added H-bar perch design
    [perchdesign_hbar_v1.stl, perchdesign_hbar_v1_10cm_height.stl]
2024-04-12 initial commit of perchdesign_tbar_v1
    [perchdesign_tbar_v1.stl]
2024-04-18 Update screw hole size on hbar to 3.8mm for M4 screws
    [perchdesign_hbar_v1_10cm_height.stl]
2024-04-18 Updated full and shortened hperch design to have longer screw holes (50mm)
    [perchdesign_hbar_v1.stl, perchdesign_hbar_v1_10cm_height.stl]
2024-04-19 Replace .stl files for hbar designs with .step files
    [perchdesign_hbar_v1.step, perchdesign_hbar_v1.stl, perchdesign_hbar_v1_10cm_height.step, perchdesign_hbar_v1_10cm_height.stl]
2024-04-19 Initial commit of test screw .step for determining correct print size of screw holes
    [testprints_screw_sizing.step]
2024-04-19 housing step files
    [housing - Box.stl, perchdesign_hbarhousingbox_v1.step, perchdesign_hbarhousinglid_v1.step, perchdesign_tbar_v2.step, perchdesign_tbarhousingbox_v1.step, perchdesign_tbarhousinglid_v1.step]
2024-05-03 Rename hperch files to nperch because it was actually n-shaped not h-shaped
    [perchdesign_nbar_v1.step, perchdesign_nbar_v1_10cm_height.step, perchdesign_nbarhousingbox_v1.step, perchdesign_nbarhousinglid_v1.step]
2024-05-30 Scale: updated print messages for easy debugging
2024-06-07 Added Tbar housing v3
    [perchdesign_hbarhousingbox_v1.step, perchdesign_hbarhousinglid_v1.step, perchdesign_tbarhousingbox_v3.step]
2024-06-07 Menu: Created script to interface with menu using DPAD (Not working)
    [dpad_menu_oleddisplay.ino]
2024-06-14 Added T-Perch Design with embedded OLED
    [perchdesign_tbar_v3.step, perchdesign_tbarhousingbox_v3.step, perchdesign_tbarhousinglid_v3.step, perchdesign_tbarslider_v1.step]
2024-06-24 Controller: BLE client code integration with menu on OLED
    [PerchScale_controller.kicad_pcb, PerchScale_controller.kicad_sch]
2024-06-28 Remove scale code from housing branch
2024-08-07 Added CAD models for controller under Housing
    [6x6 5mm Tach Buton (4 arm).SLDPRT, 6x6 5mm Tach Buton (4 arm).STEP]
2024-08-07 Added all the step modules for components in the controller
    [6x6 5mm Tach Buton (4 arm).SLDPRT, 6x6 5mm Tach Buton (4 arm).STEP, AZ-Delivery - OLED13 IIC.stp, esp32_dev_kit_v1_asm.stp, keystone-PN1042.STEP]
