tristynferreiro/perchscale/(notices)

Notices in the files:
PCB/PS_motherboard/PS_motherboard.kicad_sch:
This Schematic is licensed under MIT Open Source License. Author, Justin Pead.
